SnkMtn000/Arduino-RFM69HCW-GPS/Board_front.jpg

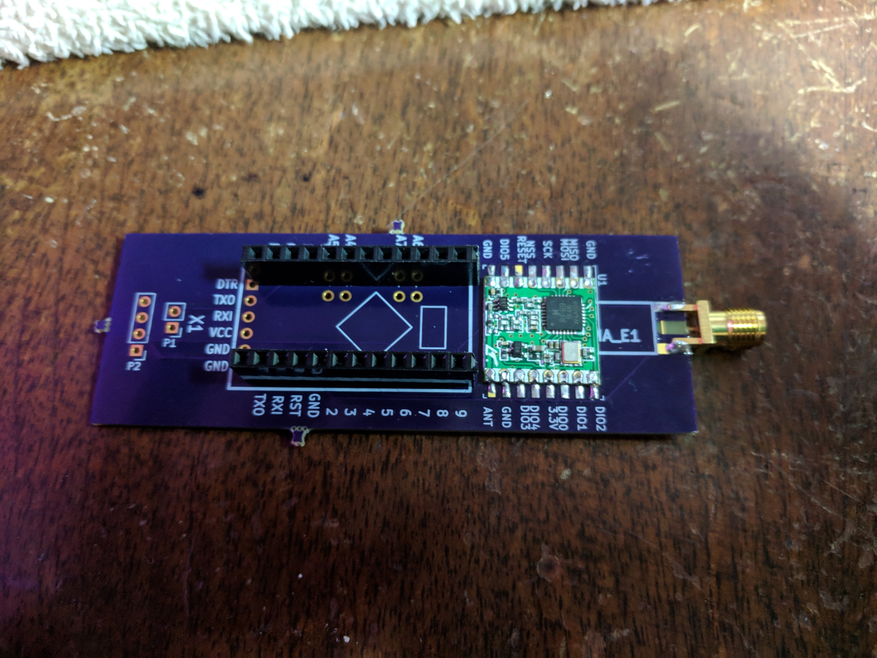
Board_front.jpg
