SnkMtn000/Arduino-RFM69HCW-GPS/Block Diagram.jpg

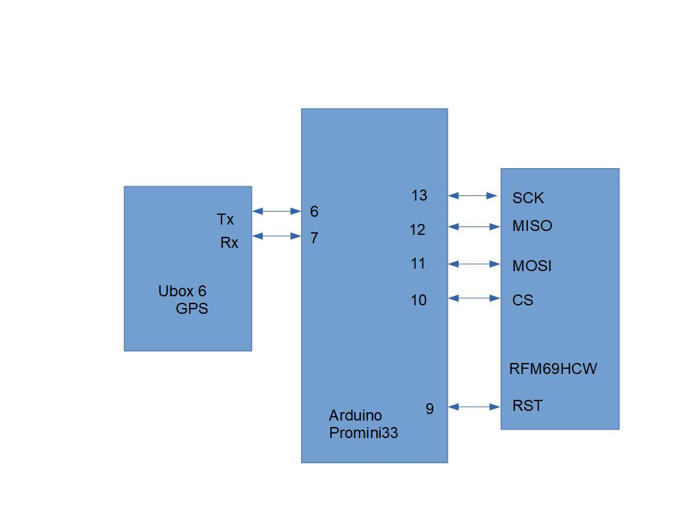
Block Diagram.jpg
