SnkMtn000/Arduino-RFM69HCW-GPS/Board_back.jpg

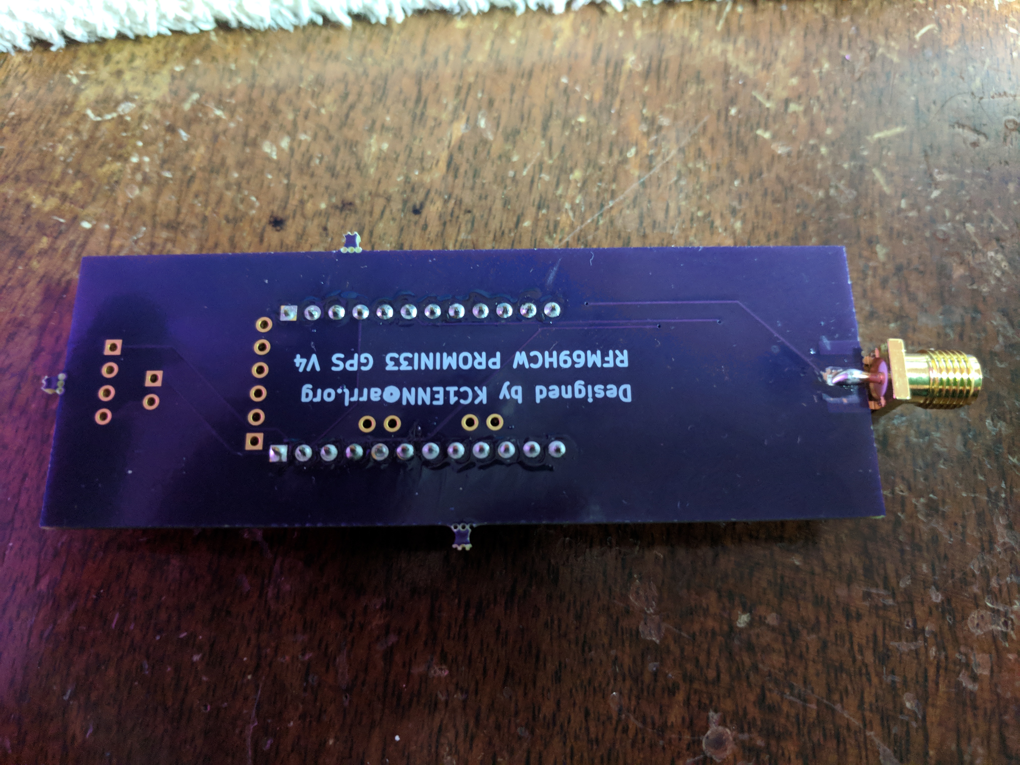
Board_back.jpg
