SnkMtn000/Arduino-RFM69HCW-GPS/board_gps.jpg

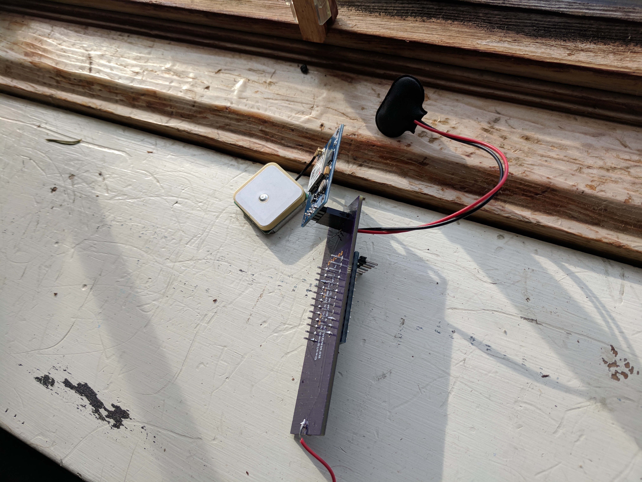
board_gps.jpg
