SnkMtn000/Arduino-RFM69HCW-GPS/sma_pad_exposed.jpg

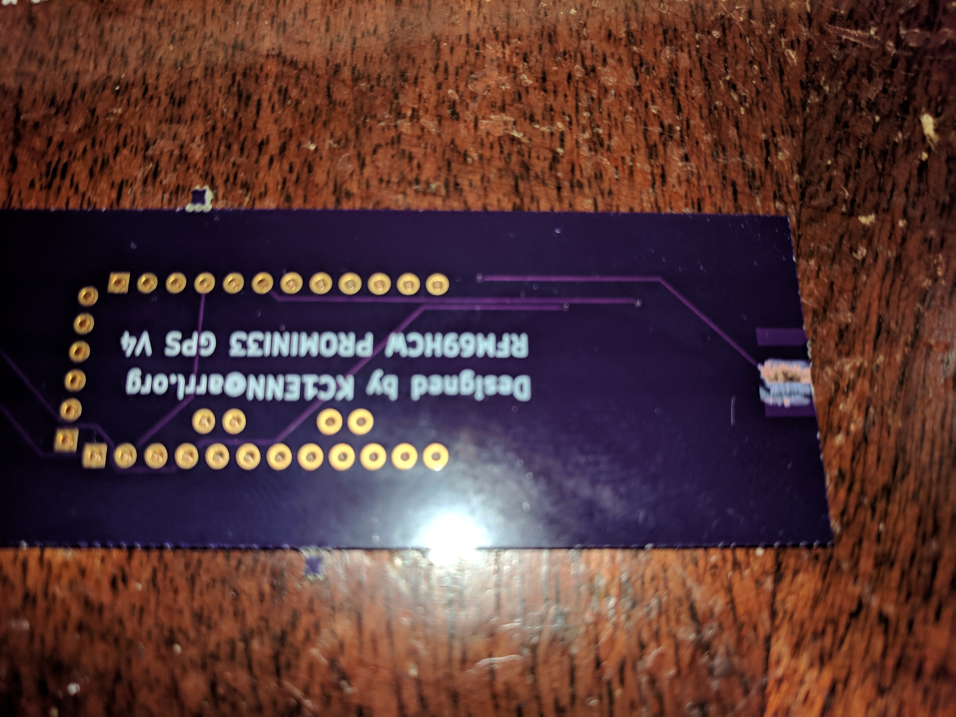
sma_pad_exposed.jpg
