SnkMtn000/Arduino-RFM69HCW-GPS/sma_pad_covered.jpg

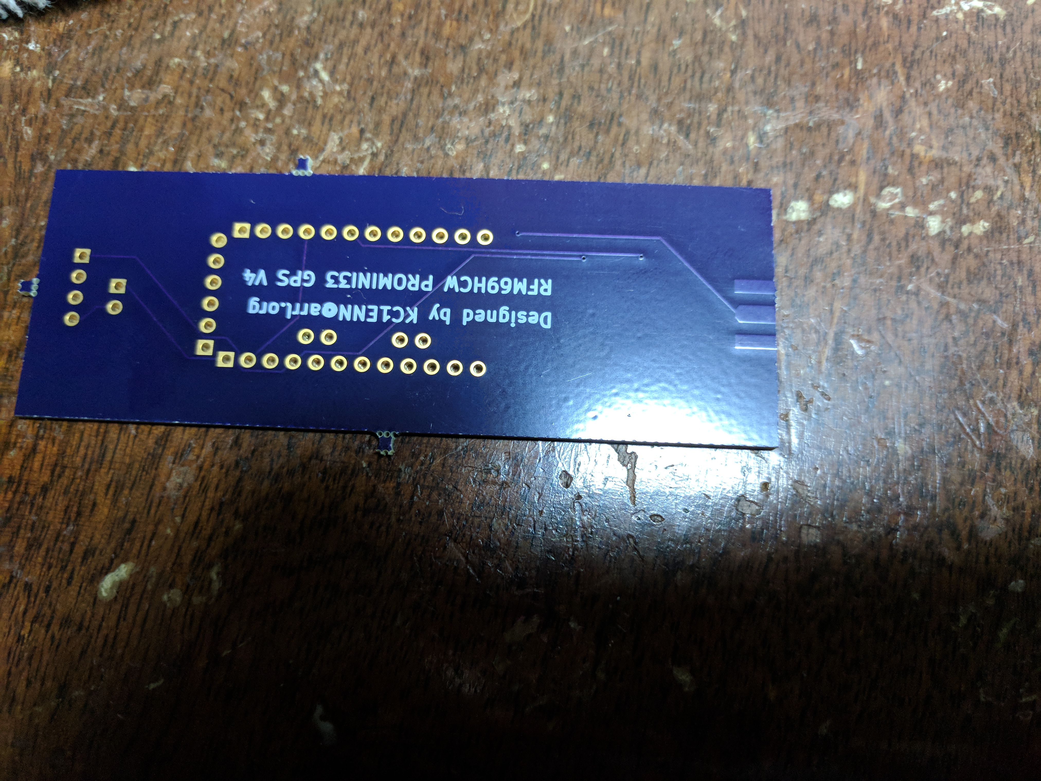
sma_pad_covered.jpg
